KargJonas/minirack/system-design/components.ods

Sheet: Sheet1
Minirack hardware selection
Iteration 1
Component | Quantity | Price | Total Price | Status | Notes
Banana Pi BPI-R3 Wi-Fi 6 Router | 1.00 | €151.00 | €151.00
CWWK Mainboard i5-8265U | 1.00 | €201.00 | €201.00
GeeekPi DeskPi RackMate T1, 8U | 1.00 | €141.17 | €141.17
MEAN WELL NPB-120-24TB Battery charger | 1.00 | €54.68 | €54.68
Landport Batteries LP T12 Bleiakku, 12 V / 26 Ah | 2.00 | €77.89 | €155.78
Victron Orion-Tr 24/12-20 DC-DC Converter | 1.00 | €50.49 | €50.49
PicoPSU Power Supply | €1.00 | €30.00 | €30.00
 |  |  | Total
 |  |  | €784.12
Iteration 2
Component | Quantity | Price | Total Price
Banana Pi BPI-R3 Wi-Fi 6 Router | 1.00 | €151.00 | €151.00
CWWK Mainboard i5-8265U | 1.00 | €201.00 | €201.00
GeeekPi DeskPi RackMate T1, 8U | 1.00 | €141.17 | €141.17
MEAN WELL NPB-120-24TB Battery charger | 1.00 | €54.68 | €54.68
Eve LF50K - LiFePO4 3.2V 50Ah - Grade A Battery | 8.00 | €16.99 | €135.92 |  | Switched from lead acid to LiFePO4
JKBMS JK-B1A8S10P Battery management sytem | 1.00 | 40.43 € | 40.43 €
Victron Orion-Tr 24/12-20 DC-DC Converter | 1.00 | €50.49 | €50.49
PicoPSU Power Supply | 1.00 | €30.00 | €30.00
 |  |  | Total
 |  |  | €804.69
Iteration 3
Component | Quantity | Price | Total Price
Cudy AX3000 v1.0 WiFi 6 Router with 2.5G LAN + 4x1G LAN | 1.00 | €49.30 | €49.30 |  | 3x cheaper router with effectively the same specs + included antennas
CWWK Mainboard i5-8265U | 1.00 | €201.00 | €201.00
GeeekPi DeskPi RackMate T1, 8U | 1.00 | €141.17 | €141.17
MEAN WELL NPB-120-24TB Battery charger | 1.00 | €54.68 | €54.68
Eve LF50K - LiFePO4 3.2V 50Ah - Grade A Battery | 8.00 | €16.99 | €135.92
JKBMS JK-B1A8S10P Battery management sytem | 1.00 | 40.43 € | 40.43 €
Victron Orion-Tr 24/12-20 DC-DC Converter | 1.00 | €50.49 | €50.49
PicoPSU Power Supply | 1.00 | €30.00 | €30.00
 |  |  | Total
 |  |  | €702.99
Iteration 4
Component | Quantity | Price | Total Price
Cudy AX3000 v1.0 WiFi 6 Router with 2.5G LAN + 4x1G LAN | 1.00 | €49.30 | €49.30
CWWK Mainboard i5-8265U | 1.00 | €201.00 | €201.00
GeeekPi DeskPi RackMate T1, 8U | 1.00 | €141.17 | €141.17
MEAN WELL NPB-360-24TB Battery charger | 1.00 | €97.67 | €97.67 |  | Upgraded battery charger from 120W to 360W for more headroom.
Eve LF50K - LiFePO4 3.2V 50Ah - Grade A Battery | 8.00 | €16.99 | €135.92
JKBMS JK-B1A8S10P Battery management sytem | 1.00 | 40.43 € | 40.43 €
Victron Orion-Tr 24/12-20 DC-DC Converter | 1.00 | €50.49 | €50.49
PicoPSU Power Supply | 1.00 | €30.00 | €30.00
 |  |  | Total
 |  |  | €745.98
Iteration 5
Component | Quantity | Price | Total Price
Cudy AX3000 v1.0 WiFi 6 Router with 2.5G LAN + 4x1G LAN | 1.00 | €49.30 | €49.30 | Received
CWWK Mainboard i5-8265U | 1.00 | €201.00 | €201.00 | Received
GeeekPi DeskPi RackMate T1, 8U | 1.00 | €141.17 | €141.17 | Received
MEAN WELL NPB-360-24TB Battery charger | 1.00 | €97.67 | €97.67 | Ordered | Li profile holds 28.8V (3.6V/cell) continuously Consider programmable variant (SBP-001) set to ~27.6V to reduce cell aging..
Eve LF50K - LiFePO4 3.2V 50Ah - Grade A Battery | 8.00 | €16.99 | €135.92 | Ordered
JKBMS JK-B1A8S10P Battery management sytem | 1.00 | €40.43 | €40.43 | Ordered
Victron Orion-Tr 24/12-20 DC-DC Converter | 1.00 | €50.49 | €50.49 | Received
PicoPSU Power Supply | 1.00 | €30.00 | €30.00 | Received
Distribution & protection: MIDI fuse + holder, blade-fuse block, bus bar, 2.5mm2 wire, lugs, crimper | 1.00 | €75.00 | €75.00 |  | Estimate.
Cell compression fixture + pack hardware | 1.00 | €20.00 | €20.00 |  | Estimate. Busbars usually ship with cells; top-balance before first assembly.
Monitoring: MCU + RTC, INA3221/INA226, battery shunt, temp/humidity sensors | 1.00 | €40.00 | €40.00 | Ordered | Estimate.
 |  |  | Total
 |  |  | €880.98

Sheet: Sheet2
Rack manager hardware selection
Iteration 1
Component | Quantity | Price | Total Price | Status | Notes
WT32-ETH01 Microcontroller Board | 1.00 | 6.06 € | 6.06 € |  | Rationale: Since the ESP32 is built for networking, we can connect it directly to the Switch, which means it stays accessible even if the other components go Down, which is what we need from a rack manager. Aside from that, this board is cheap, already has an RJ45 connector, Has good arduino support, does not require an OS, which improves Reliability, has plenty of digital and analog IO and allows programming Over ethernet with the right firmware. Perfect fit overall
TCA9548A I2C Multiplexer | 1.00 | 0.39 € | 0.39 €
AHT20 + BMP280 Temperature, Pressure, Humidity Sensor Board | 6.00 | 0.94 € | 5.64 €
QNPT03 2mA/2mA Potential Transformer | 5.00 | 0.48 € | 2.40 € |  | Bought 4 more than needed for future projects
QNCT16L 2000-1 50A Current Transformer | 5.00 | 0.71 € | 3.55 € |  | Bought 4 more than needed for future projects
ADS131M02IRUKR | 2.00 | 1.45 € | 2.90 € |  | For voltage/current measurement at AC input and at the 12V rail
