KargJonas/minirack/cad/layout/layout.FCStd

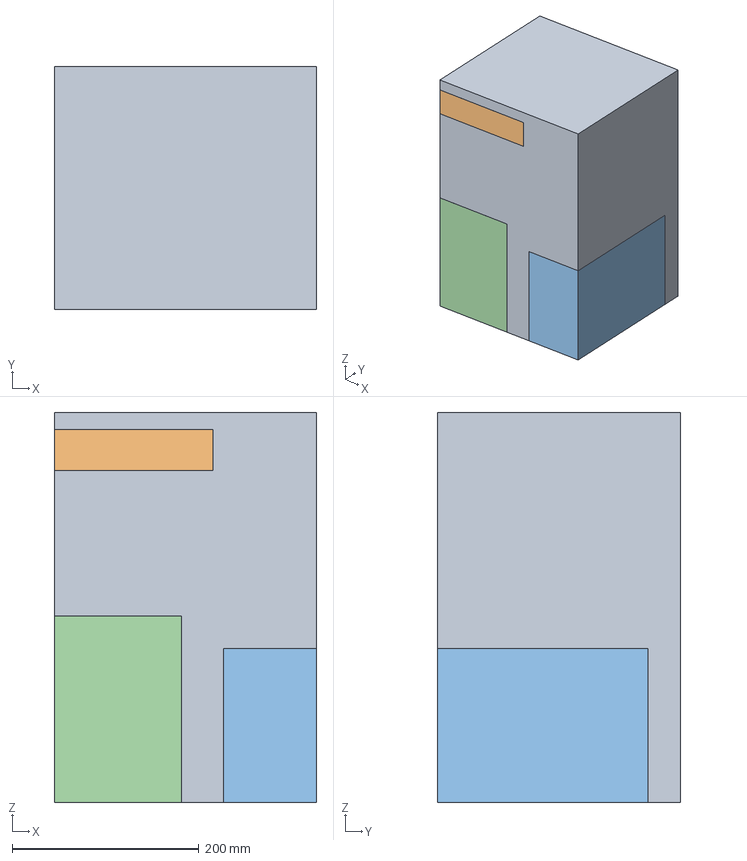
[picture p1: CAD file, 2026-07-11]
cad/layout/layout.FCStd
281.0 x 260.0 x 418.0 mm
Usable Volume
Mainboard
NAS
Battery
