KargJonas/minirack/cad/mini-itx-dimensions/Mini-ITX.STEP

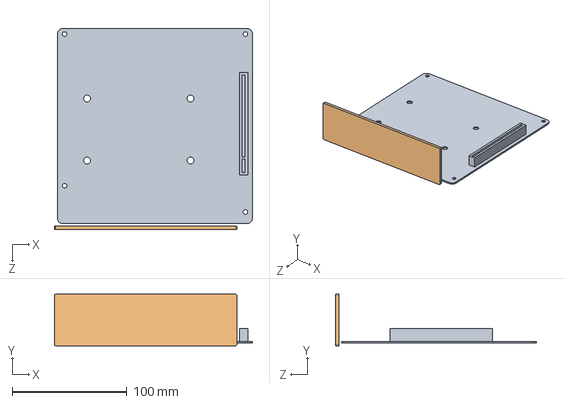
[picture p2: CAD file, 2026-07-11]
cad/mini-itx-dimensions/Mini-ITX.STEP
172.4 x 44.9 x 175.1 mm
