KargJonas/minirack/cad/shelves/3d-printing-files/packed-parts.3mf

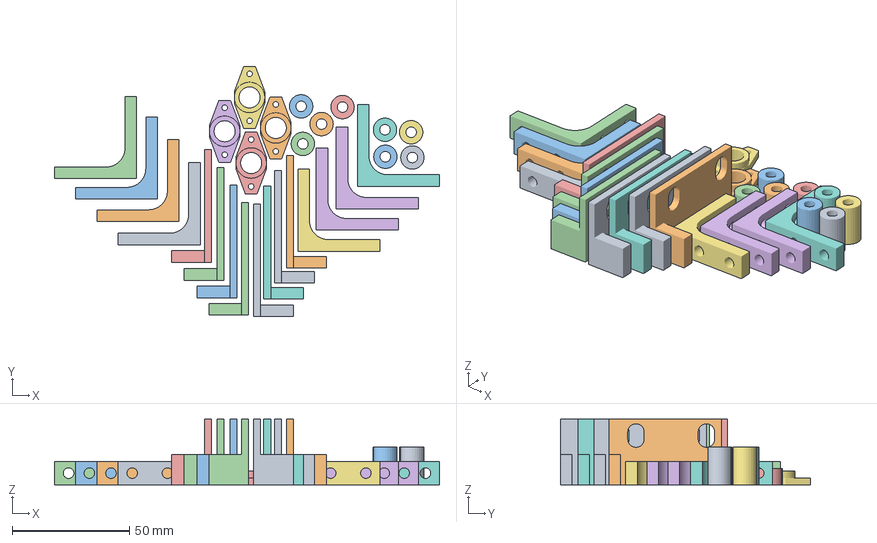
[picture p3: CAD file, 2026-07-16]
cad/shelves/3d-printing-files/packed-parts.3mf
163.9 x 106.5 x 28.0 mm
rear-mount-left.3mf
antenna-holder.3mf
router-spacer.3mf
rear-mount-right.3mf
mini-itx-spacer.3mf
gusset.3mf
router-spacer.3mf(1)
router-spacer.3mf(2)
router-spacer.3mf(3)
mini-itx-spacer.3mf(1)
mini-itx-spacer.3mf(2)
mini-itx-spacer.3mf(3)
antenna-holder.3mf(1)
antenna-holder.3mf(2)
antenna-holder.3mf(3)
rear-mount-left.3mf(1)
rear-mount-left.3mf(2)
rear-mount-left.3mf(3)
rear-mount-right.3mf(1)
rear-mount-right.3mf(2)
rear-mount-right.3mf(3)
gusset.3mf(1)
gusset.3mf(2)
gusset.3mf(3)
gusset.3mf(4)
gusset.3mf(5)
gusset.3mf(6)
gusset.3mf(7)
