KargJonas/minirack/cad/shelves/antenna-holder-flat.FCStd

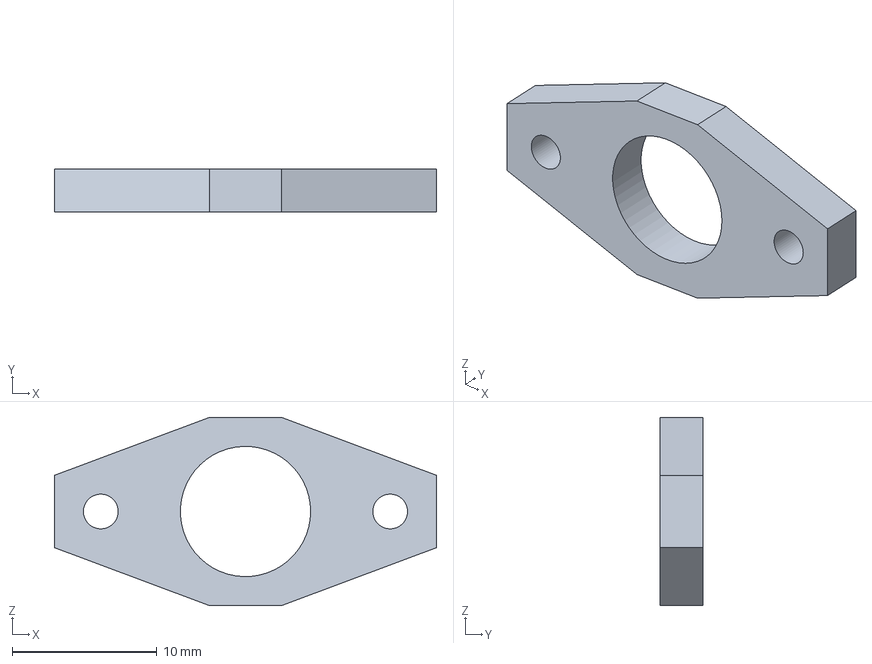
[picture p4: CAD file, 2026-10-18]
cad/shelves/antenna-holder-flat.FCStd
26.4 x 3.00 x 13.0 mm
