KargJonas/minirack/cad/shelves/cnc-files/rack-bottom-plate-Body.step

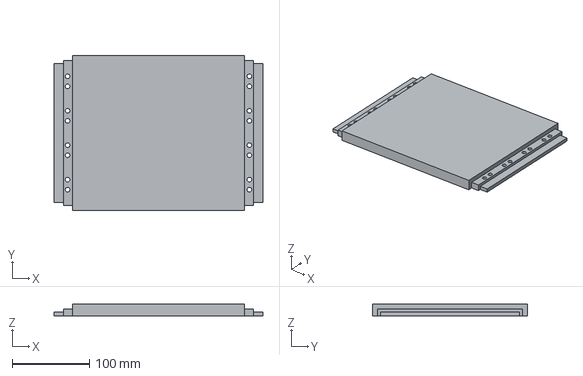
[picture p5: CAD file, 2026-07-21]
cad/shelves/cnc-files/rack-bottom-plate-Body.step
270.0 x 200.0 x 15.0 mm
