KargJonas/minirack/rack-manager/eda/symbols/ADS131M02IRUKR/RUK0020B.stp

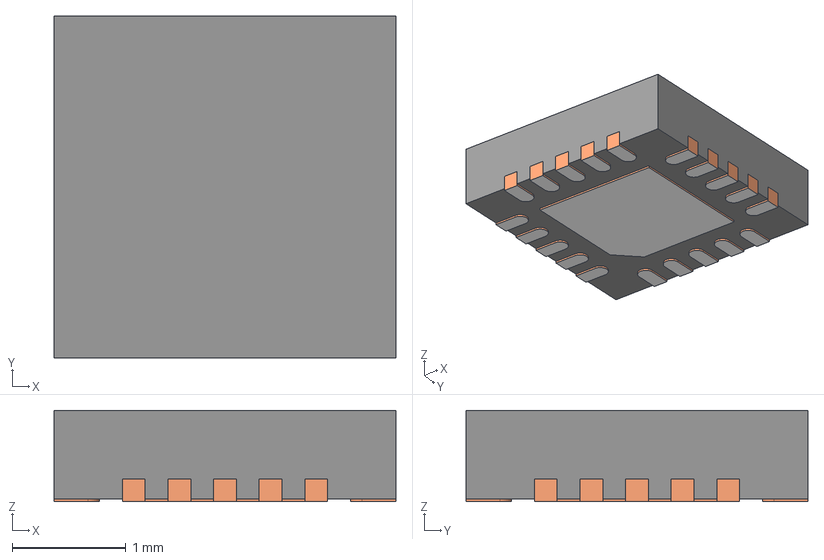
[picture p6: CAD file, 2026-07-13]
rack-manager/eda/symbols/ADS131M02IRUKR/RUK0020B.stp
3.00 x 3.00 x 0.8 mm
BODY-QFN
FRAME-RUK0020B
PIN1-ID
