KargJonas/minirack/cad/misc/power-rail-box-bottom-Body.3mf

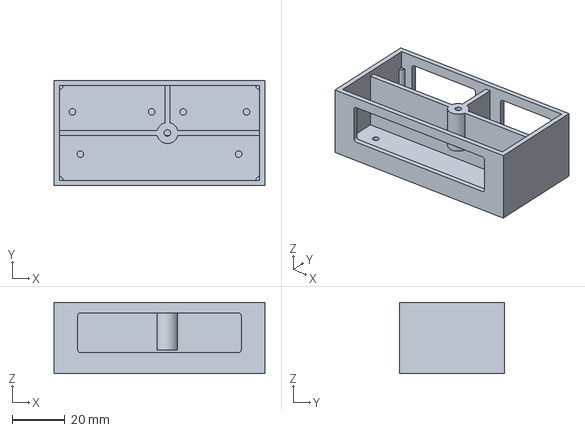
[picture p7: CAD file, 2026-10-18]
cad/misc/power-rail-box-bottom-Body.3mf
80.0 x 40.0 x 27.0 mm
