KargJonas/minirack/cad/shelves/cnc-files/router-shelf-bottom-plate-with-ventillation.dxf

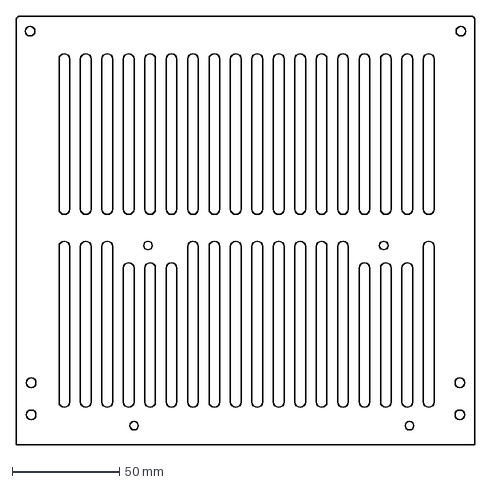
[picture p8: CAD file, 2026-07-18]
cad/shelves/cnc-files/router-shelf-bottom-plate-with-ventillation.dxf
214.0 x 200.0 mm
