KargJonas/minirack/cad/misc/power-rail-box.FCStd

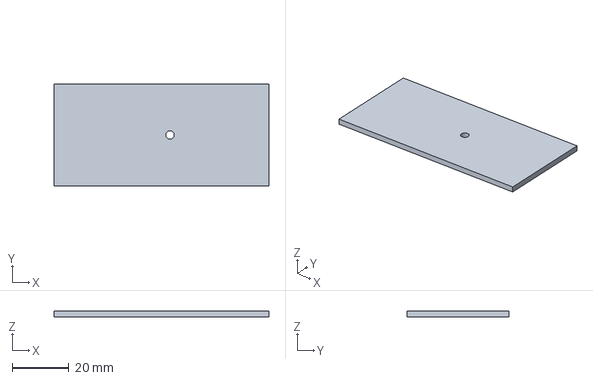
[picture p9: CAD file, 2026-10-18]
cad/misc/power-rail-box.FCStd
76.0 x 36.0 x 2.00 mm
