KargJonas/minirack/cad/shelves/mini-itx-shelf.FCStd

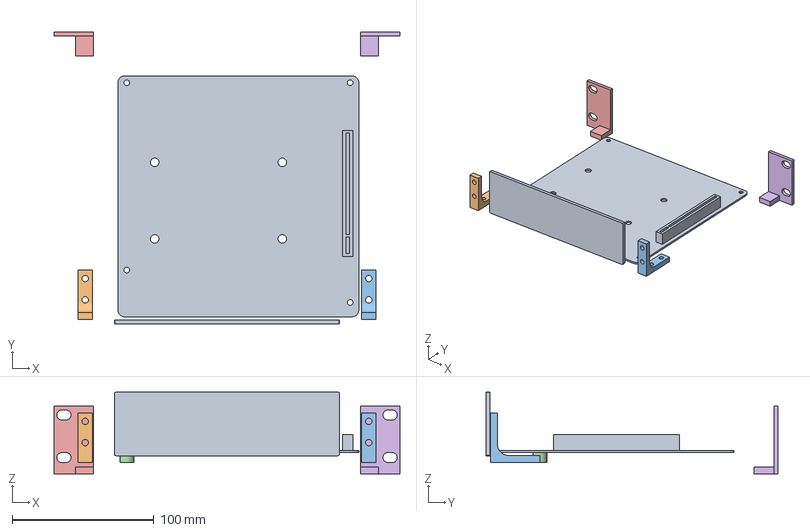
[picture p11: CAD file, 2026-09-18]
cad/shelves/mini-itx-shelf.FCStd
244.0 x 206.1 x 57.6 mm
Mini-ITX-Reference
gusset-reference-1
gusset-reference-2
mini-itx-spacer
rear-mount-left
rear-mount-right
