KargJonas/minirack/cad/misc/CE3E3V2_power-rail-box-Body.3mf

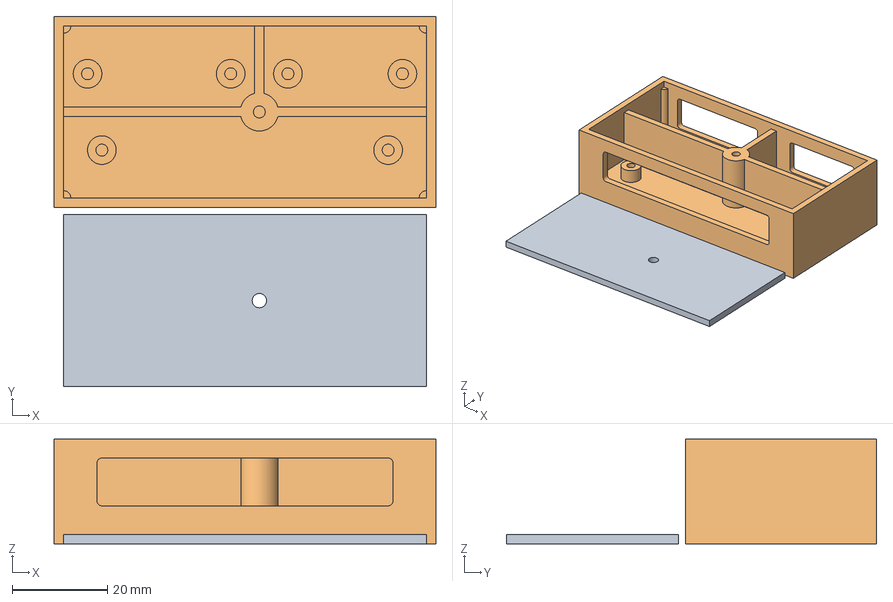
[picture p12: CAD file, 2026-10-18]
cad/misc/CE3E3V2_power-rail-box-Body.3mf
80.0 x 77.5 x 22.0 mm
power-rail-box-Body.3mf
power-rail-box-bottom-Body.3mf
