KargJonas/minirack/cad/shelves/router-shelf.FCStd

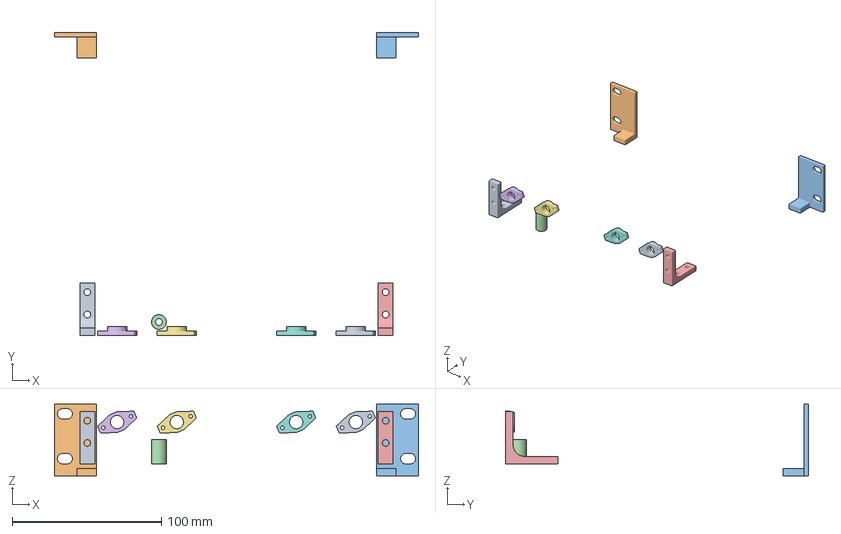
[picture p14: CAD file, 2026-09-18]
cad/shelves/router-shelf.FCStd
244.0 x 203.0 x 48.0 mm
gusset-reference-1
rear-mount-left
rear-mount-right
router-spacer
gusset-reference-2
antenna-holder-reference-1
antenna-holder-reference-2
antenna-holder-reference-3
antenna-holder-reference-4
