KargJonas/minirack/cad/shelves/antenna-holder.FCStd

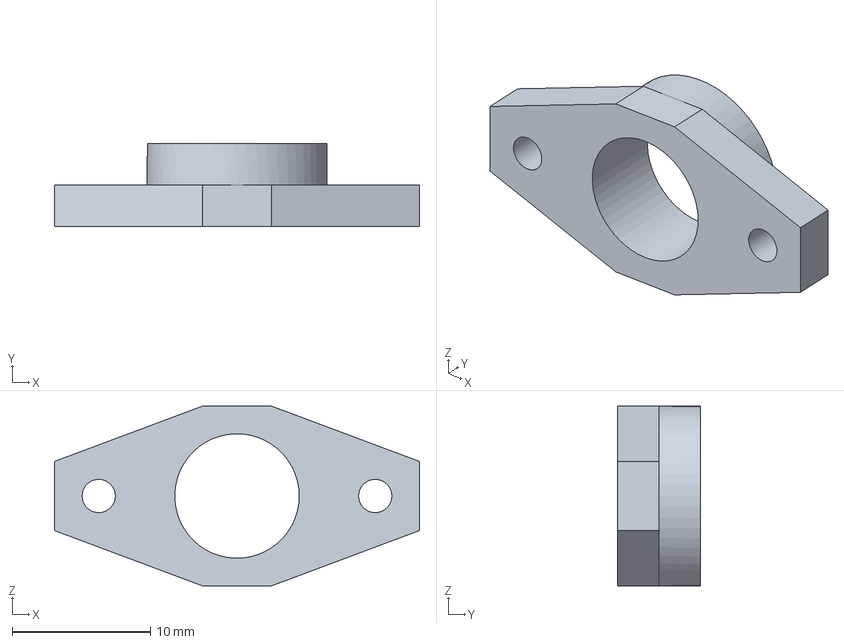
[picture p15: CAD file, 2026-07-15]
cad/shelves/antenna-holder.FCStd
26.4 x 6.00 x 13.0 mm
