KargJonas/minirack/cad/shelves/cnc-files/2u-shelf-front-plate.dxf

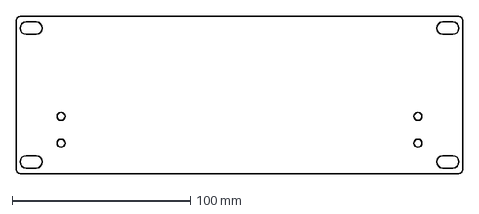
[picture p17: CAD file, 2026-07-15]
cad/shelves/cnc-files/2u-shelf-front-plate.dxf
250.0 x 88.0 mm
