KargJonas/minirack/cad/shelves/rear-mount-left.FCStd

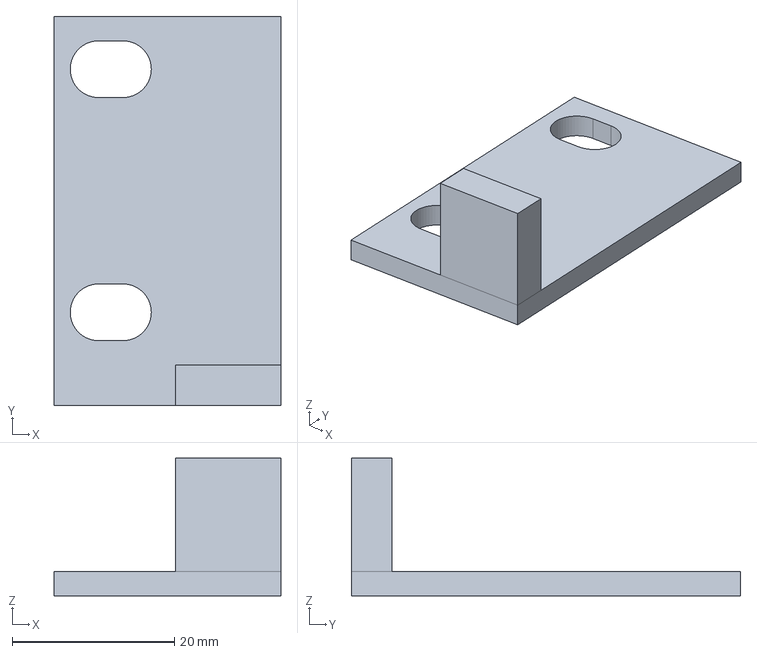
[picture p18: CAD file, 2026-07-15]
cad/shelves/rear-mount-left.FCStd
28.0 x 48.0 x 17.0 mm
