KargJonas/minirack/cad/shelves/cnc-files/mini-itx-shelf-front-plate.dxf

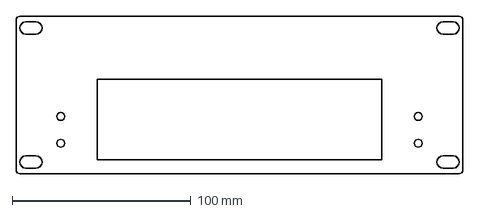
[picture p19: CAD file, 2026-07-15]
cad/shelves/cnc-files/mini-itx-shelf-front-plate.dxf
250.0 x 88.0 mm
