KargJonas/minirack/cad/shelves/cnc-files/1u-shelf-front-plate.dxf

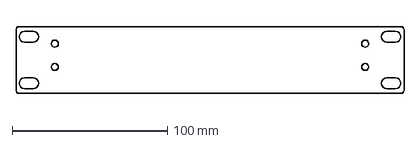
[picture p20: CAD file, 2026-07-15]
cad/shelves/cnc-files/1u-shelf-front-plate.dxf
250.0 x 43.0 mm
