KargJonas/minirack/cad/shelves/router-spacer.3mf

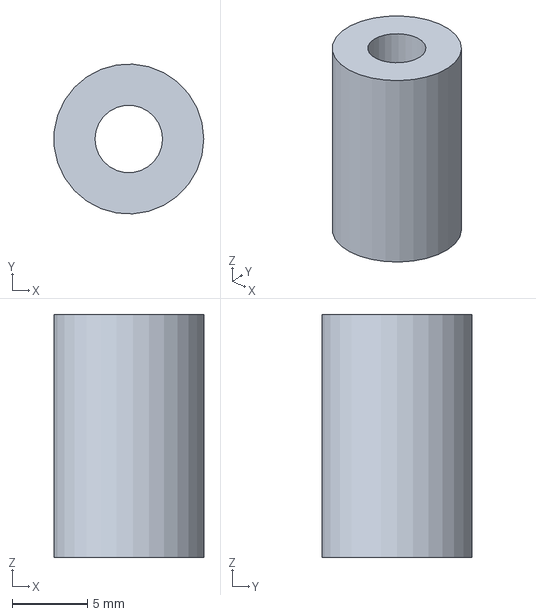
[picture p21: CAD file, 2026-07-15]
cad/shelves/router-spacer.3mf
9.97 x 9.99 x 16.2 mm
