KargJonas/minirack/cad/shelves/cnc-files/router-shelf-front-plate.dxf

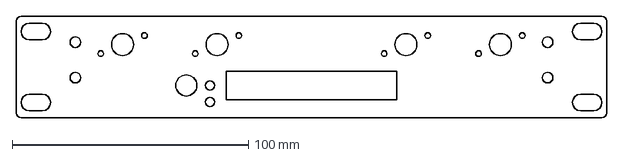
[picture p22: CAD file, 2026-07-15]
cad/shelves/cnc-files/router-shelf-front-plate.dxf
250.0 x 43.0 mm
