KargJonas/minirack/cad/shelves/cnc-files/mini-itx-shelf-bottom-plate.dxf

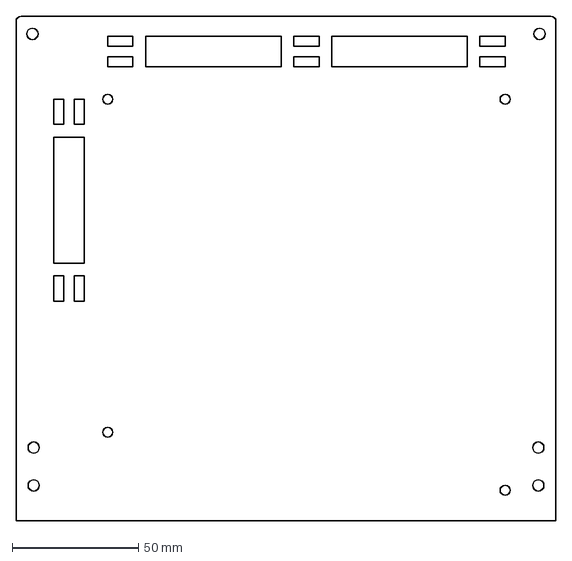
[picture p23: CAD file, 2026-07-15]
cad/shelves/cnc-files/mini-itx-shelf-bottom-plate.dxf
214.0 x 200.0 mm
