KargJonas/minirack/cad/shelves/gusset.FCStd

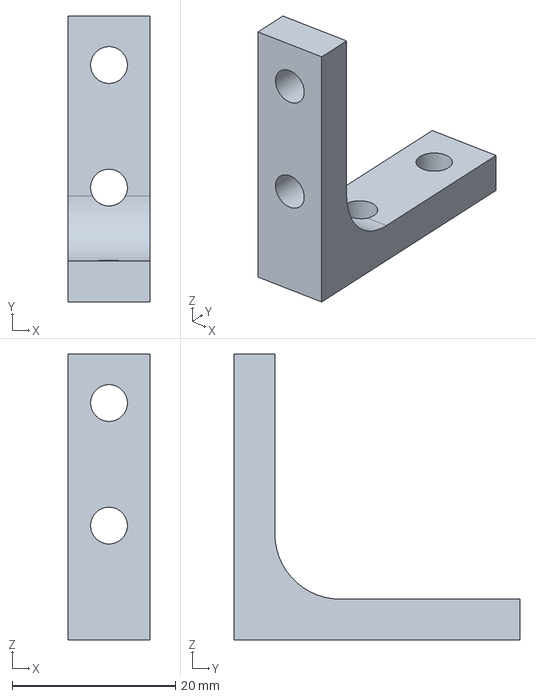
[picture p24: CAD file, 2026-07-15]
cad/shelves/gusset.FCStd
10.0 x 35.0 x 35.0 mm
