KargJonas/minirack/cad/shelves/mini-itx-spacer.3mf

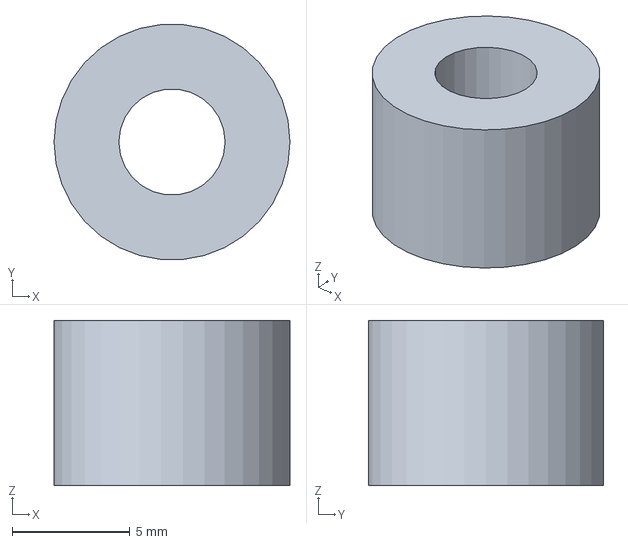
[picture p25: CAD file, 2026-07-15]
cad/shelves/mini-itx-spacer.3mf
10.0 x 9.96 x 7.00 mm
