KargJonas/minirack/cad/shelves/itxflex_2u.fcstd

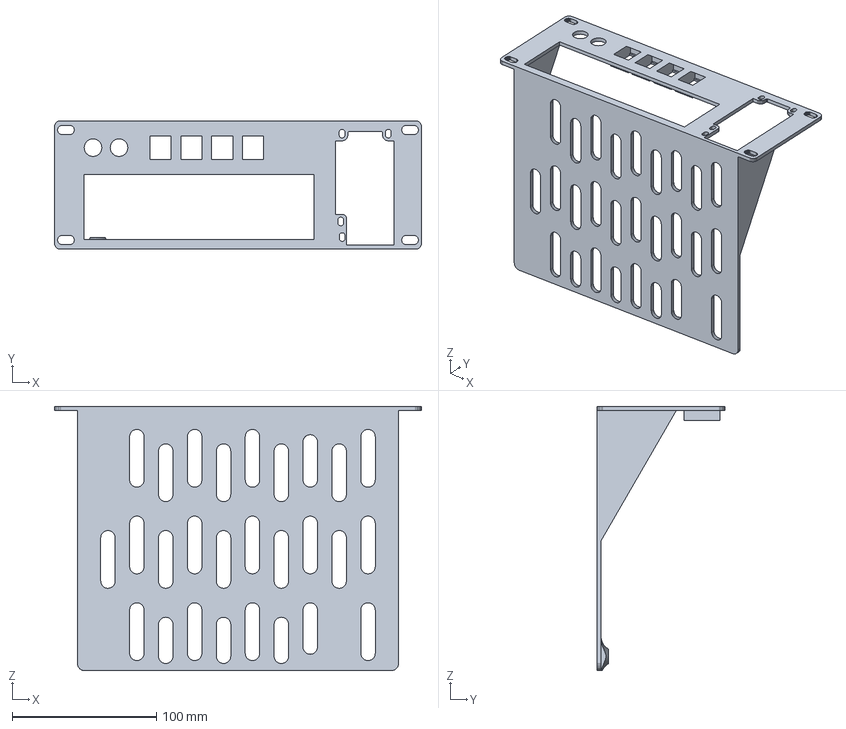
[picture p26: CAD file, 2026-07-11]
cad/shelves/itxflex_2u.fcstd
254.0 x 88.9 x 183.0 mm
