KargJonas/minirack/(list of files, cad)

Other CAD files:
cad/misc/test.FCStd
cad/shelves/rack-bottom-plate.FCStd
cad/misc/power-rail-box-bottom.FCStd
cad/misc/power-rail-box-Body.3mf
cad/shelves/1u-shelf.FCStd
cad/shelves/rear-mount-right.FCStd
cad/shelves/2u-shelf.FCStd
cad/shelves/router-spacers.FCStd
cad/shelves/mini-itx-spacers.FCStd
cad/shelves/antenna-holder-flat.3mf
cad/shelves/antenna-holder.3mf
cad/shelves/gusset.3mf
cad/shelves/rear-mount-left.3mf
cad/shelves/rear-mount-right.3mf
