KargJonas/minirack/rack-manager/bringup/easy-ota/partitions_4mb.csv

# Shared partition table for all builds (4MB flash). Plain A/B:
# the serial flash puts the base image (EasyOTA only) into ota_0; every HTTP
# upload goes to the slot not currently running. A bad upload rolls back to
# the previous image; bad-but-validated images are handled by EasyOTA's
# crash-loop guard and reachability watchdog (see lib/EasyOTA).
# coredump holds the crash dump of the most recent panic, reported via
# /status for rollback diagnostics.
# Name,     Type, SubType,  Offset,   Size
nvs,        data, nvs,      0x9000,   0x5000,
otadata,    data, ota,      0xe000,   0x2000,
ota_0,      app,  ota_0,    0x10000,  0x1e0000,
ota_1,      app,  ota_1,    0x1f0000, 0x1e0000,
coredump,   data, coredump, 0x3d0000, 0x30000,
