KargJonas/minirack/cad/bottom-plate.pdf

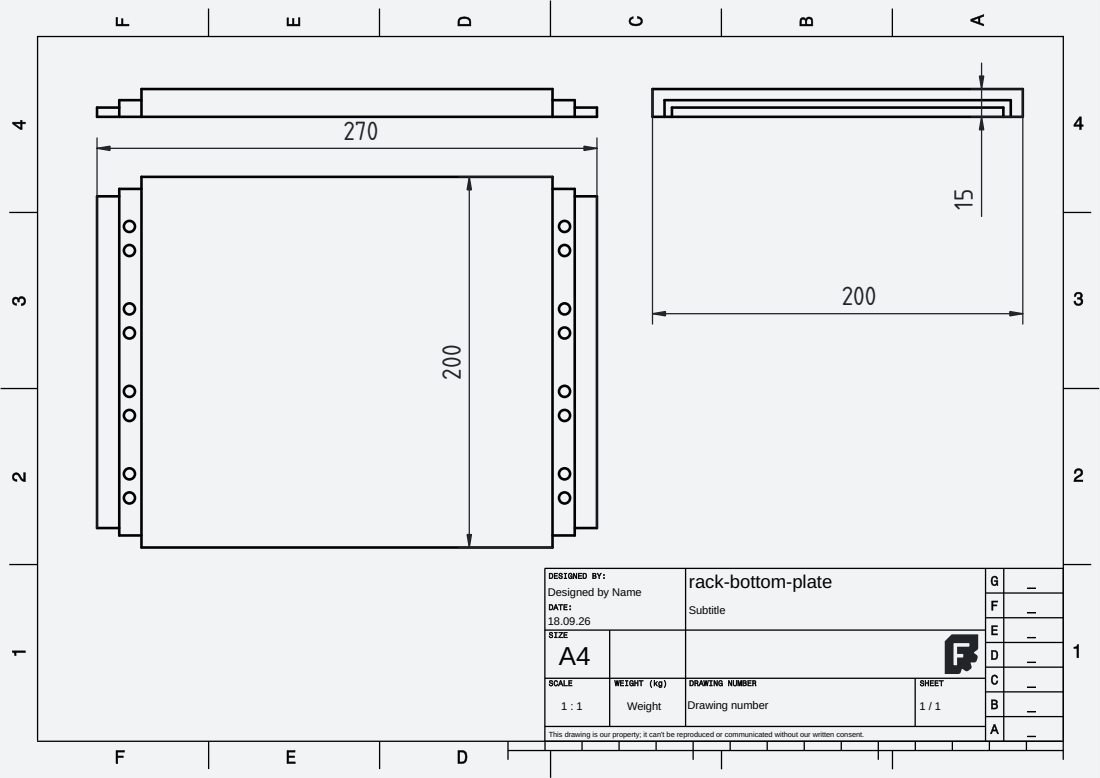
[picture p27: page 1]

Designed by Name 18.09.26 | rack-bottom-plate Subtitle

1 : 1 | Weight | Drawing number | 1 / 1

This drawing is our property; it can't be reproduced or communicated without our written consent.
