KargJonas/minirack/cad/router-plates-drawing.pdf

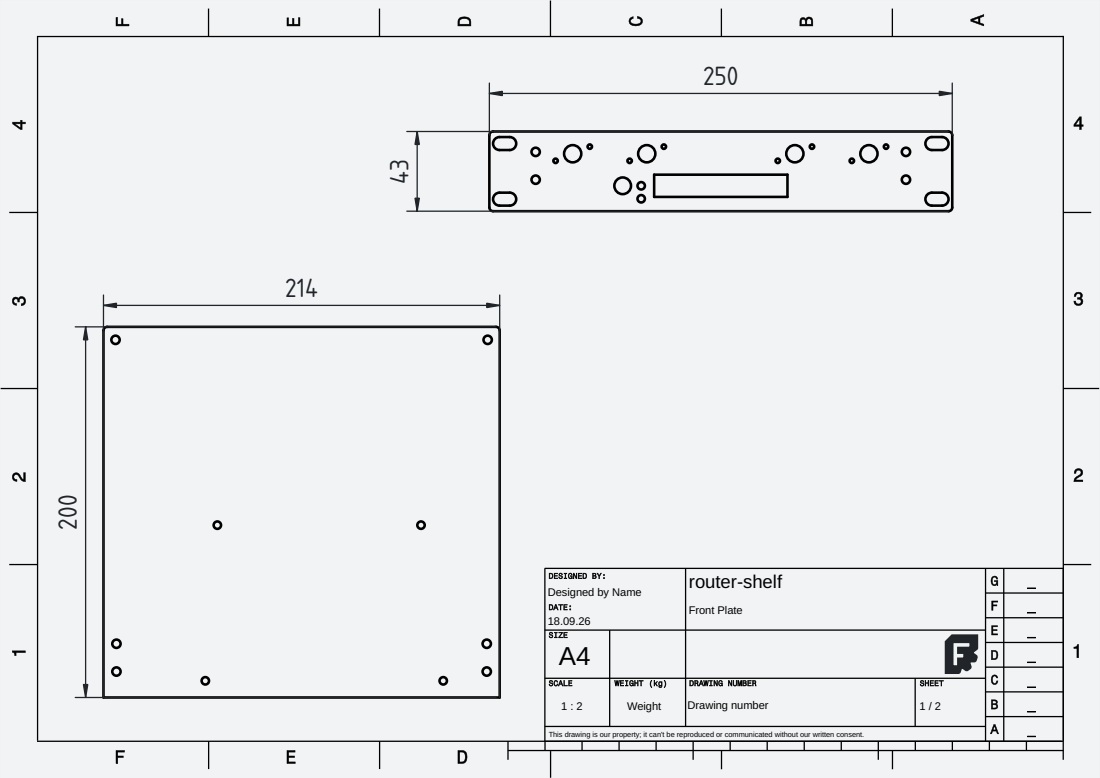
[picture p28: page 1]

Designed by Name 18.09.26 | router-shelf Front Plate

1 : 2 | Weight | Drawing number | 1 / 2

This drawing is our property; it can't be reproduced or communicated without our written consent.
