KargJonas/minirack/cad/mini-itx-plates-drawing.pdf

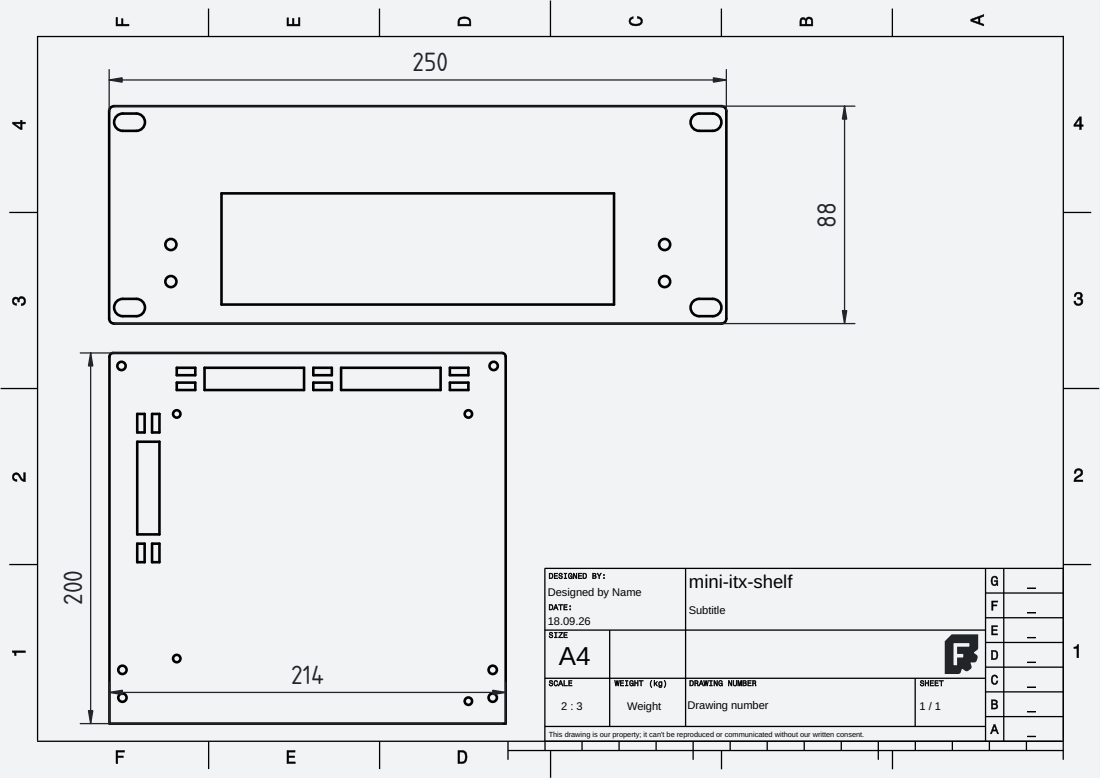
[picture p29: page 1]

Designed by Name 18.09.26 | mini-itx-shelf Subtitle

2 : 3 | Weight | Drawing number | 1 / 1

This drawing is our property; it can't be reproduced or communicated without our written consent.
