KargJonas/minirack/rack-manager/eda/rack-manager/rack-manager/rack-manager.kicad_pcb

## KiCad design rack-manager/eda/rack-manager/rack-manager/rack-manager.kicad_pcb (2026-07-15)

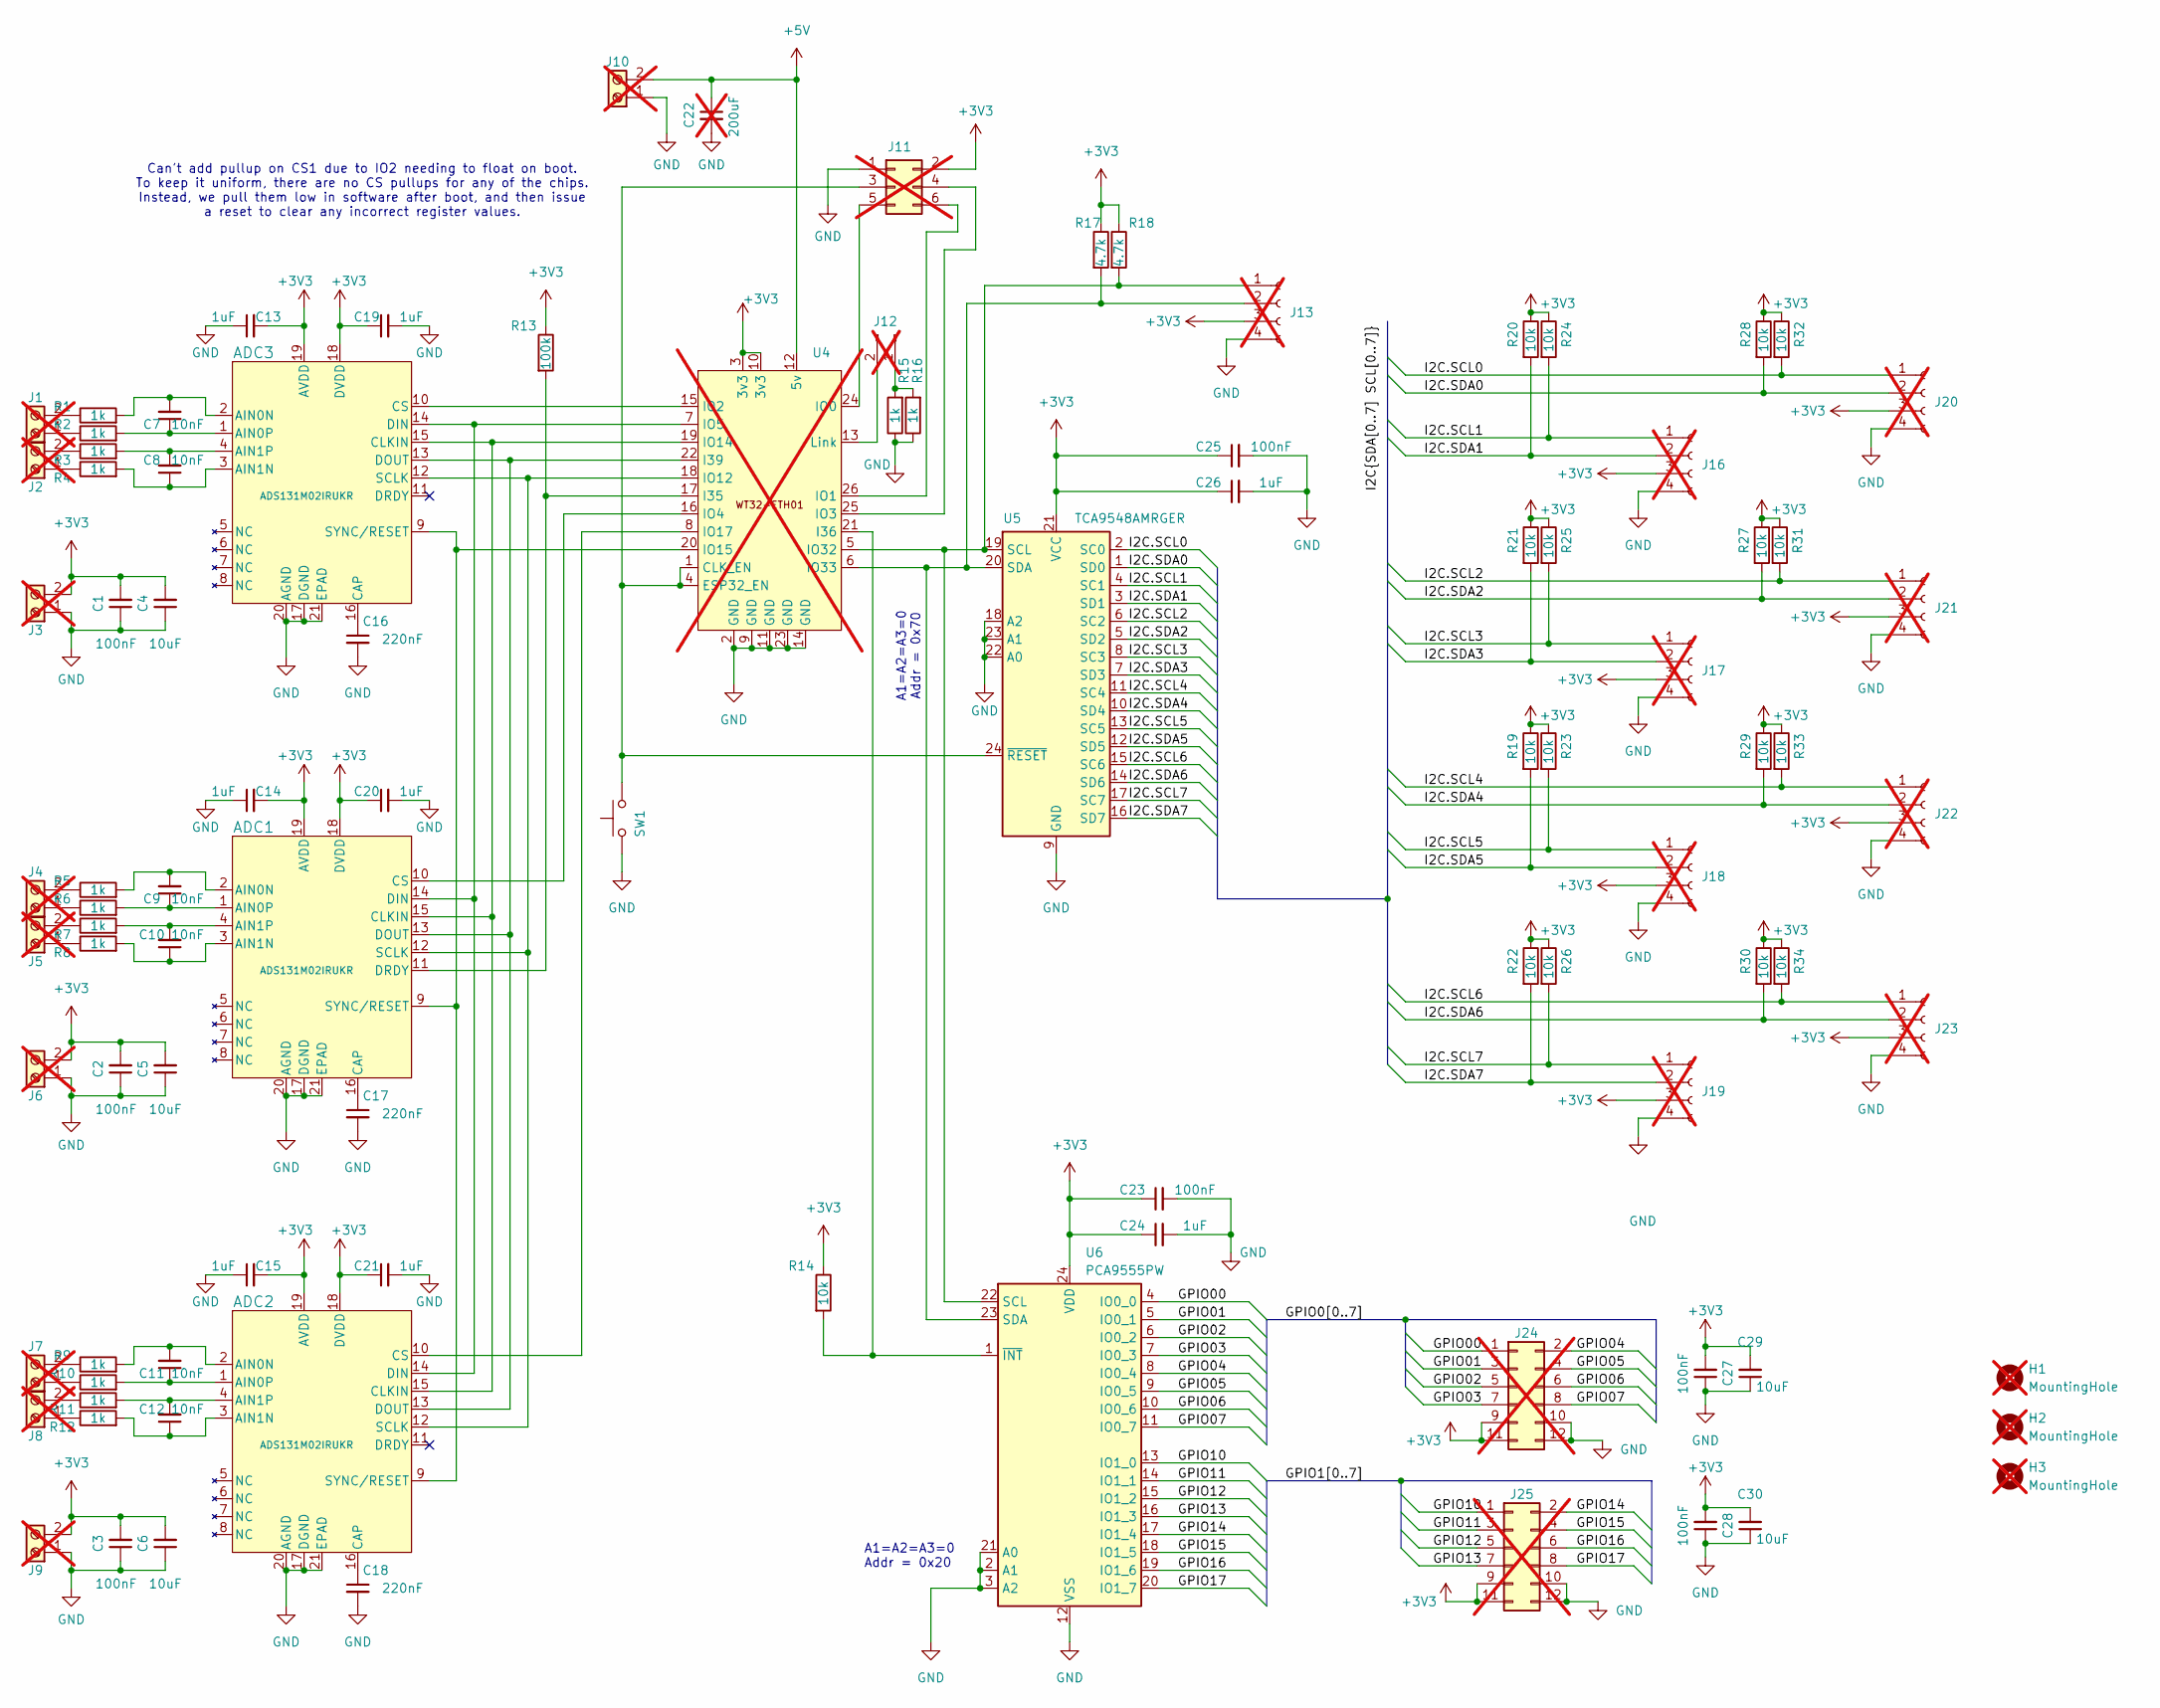
[picture p30: schematic rack-manager.kicad_sch]

Parts:
ADC1, ADC2, ADC3: ADS131M02IRUKR; WQFN-20-1EP_3x3mm_P0.4mm_EP1.7x1.7mm; LCSC C5215160
C1, C2, C3, C23, C25, C27, C28: 100nF; C_0603_1608Metric; LCSC C14663
C4, C5, C6, C29, C30: 10uF; C_0603_1608Metric; LCSC C19702
C7, C8, C9, C10, C11, C12: 10nF; C_0603_1608Metric; LCSC C57112
C13, C14, C15, C19, C20, C21, C24, C26: 1uF; C_0603_1608Metric; LCSC C15849
C16, C17, C18: 220nF; C_0603_1608Metric; LCSC C21120
C22: 200uF; CP_Radial_D8.0mm_P3.50mm; not fitted
H1, H2, H3: MountingHole; MountingHole_4.3mm_M4_ISO14580_Pad_TopBottom; not fitted
J1, J2, J3, J4, J5, J6, J7, J8, J9, J10: Screw_Terminal_01x02; TerminalBlock_Phoenix_MKDS-1-2-3.81_1x02_P3.81mm_Horizontal; not fitted
J11: Conn_02x03_Odd_Even; IDC-Header_2x03_P2.54mm_Vertical; not fitted
J12: Conn_01x02_Pin; PinHeader_1x02_P2.54mm_Vertical; not fitted
J13, J16, J17, J18, J19, J20, J21, J22, J23: Conn_01x04_Socket; JST_XH_B4B-XH-A_1x04_P2.50mm_Vertical; not fitted
J24, J25: Conn_02x06_Odd_Even; IDC-Header_2x06_P2.54mm_Vertical; not fitted
R1, R2, R3, R4, R5, R6, R7, R8, R9, R10, R11, R12, R15, R16: 1k; R_0603_1608Metric; LCSC C21190
R13: 100k; R_0603_1608Metric; LCSC C25803
R14, R19, R20, R21, R22, R23, R24, R25, R26, R27, R28, R29, R30, R31, R32, R33, R34: 10k; R_0603_1608Metric; LCSC C25804
R17, R18: 4.7k; R_0603_1608Metric; LCSC C23162
SW1: C720477; SW_Push_SPST_NO_Alps_SKRK; LCSC C720477
U4: WT32-ETH01; not fitted
U5: TCA9548AMRGER; Texas_RGE0024C_VQFN-24-1EP_4x4mm_P0.5mm_EP2.1x2.1mm
U6: PCA9555PW; TSSOP-24_4.4x7.8mm_P0.65mm

Connections:
+3V3: ADC1.18 (DVDD), ADC1.19 (AVDD), ADC2.18 (DVDD), ADC2.19 (AVDD), ADC3.18 (DVDD), ADC3.19 (AVDD), C1.2, C2.2, C3.2, C4.2, C5.2, C6.2, C13.2, C14.2, C15.2, C19.1, C20.1, C21.1, C23.1, C24.1, C25.1, C26.1, C27.2, C28.2, C29.2, C30.2, J3.2, J6.2, J9.2, J11.2, J13.3, J16.3, J17.3, J18.3, J19.3, J20.3, J21.3, J22.3, J23.3, J24.9, J24.11, J25.9, J25.11, R13.1, R14.1, R17.1, R18.1, R19.1, R20.1, R21.1, R22.1, R23.1, R24.1, R25.1, R26.1, R27.1, R28.1, R29.1, R30.1, R31.1, R32.1, R33.1, R34.1, U4.3 (3v3), U4.10 (3v3), U5.21 (VCC), U6.24 (VDD)
+5V: C22.1, J10.2, U4.12 (5v)
/GPIO00: J24.1, U6.4 (IO0_0)
/GPIO01: J24.3, U6.5 (IO0_1)
/GPIO02: J24.5, U6.6 (IO0_2)
/GPIO03: J24.7, U6.7 (IO0_3)
/GPIO04: J24.2, U6.8 (IO0_4)
/GPIO05: J24.4, U6.9 (IO0_5)
/GPIO06: J24.6, U6.10 (IO0_6)
/GPIO07: J24.8, U6.11 (IO0_7)
/GPIO10: J25.1, U6.13 (IO1_0)
/GPIO11: J25.3, U6.14 (IO1_1)
/GPIO12: J25.5, U6.15 (IO1_2)
/GPIO13: J25.7, U6.16 (IO1_3)
/GPIO14: J25.2, U6.17 (IO1_4)
/GPIO15: J25.4, U6.18 (IO1_5)
/GPIO16: J25.6, U6.19 (IO1_6)
/GPIO17: J25.8, U6.20 (IO1_7)
/I2C.SCL0: J20.1, R32.2, U5.2 (SC0)
/I2C.SCL1: J16.1, R24.2, U5.4 (SC1)
/I2C.SCL2: J21.1, R31.2, U5.6 (SC2)
/I2C.SCL3: J17.1, R25.2, U5.8 (SC3)
/I2C.SCL4: J22.1, R33.2, U5.11 (SC4)
/I2C.SCL5: J18.1, R23.2, U5.13 (SC5)
/I2C.SCL6: J23.1, R34.2, U5.15 (SC6)
/I2C.SCL7: J19.1, R26.2, U5.17 (SC7)
/I2C.SDA0: J20.2, R28.2, U5.1 (SD0)
/I2C.SDA1: J16.2, R20.2, U5.3 (SD1)
/I2C.SDA2: J21.2, R27.2, U5.5 (SD2)
/I2C.SDA3: J17.2, R21.2, U5.7 (SD3)
/I2C.SDA4: J22.2, R29.2, U5.10 (SD4)
/I2C.SDA5: J18.2, R19.2, U5.12 (SD5)
/I2C.SDA6: J23.2, R30.2, U5.14 (SD6)
/I2C.SDA7: J19.2, R22.2, U5.16 (SD7)
GND: ADC1.17 (DGND), ADC1.20 (AGND), ADC1.21 (EPAD), ADC2.17 (DGND), ADC2.20 (AGND), ADC2.21 (EPAD), ADC3.17 (DGND), ADC3.20 (AGND), ADC3.21 (EPAD), C1.1, C2.1, C3.1, C4.1, C5.1, C6.1, C13.1, C14.1, C15.1, C16.2, C17.2, C18.2, C19.2, C20.2, C21.2, C22.2, C23.2, C24.2, C25.2, C26.2, C27.1, C28.1, C29.1, C30.1, J3.1, J6.1, J9.1, J10.1, J11.1, J13.4, J16.4, J17.4, J18.4, J19.4, J20.4, J21.4, J22.4, J23.4, J24.10, J24.12, J25.10, J25.12, R15.1, R16.1, SW1.1, U4.2 (GND), U4.9 (GND), U4.11 (GND), U4.14 (GND), U4.23 (GND), U5.9 (GND), U5.18 (A2), U5.22 (A0), U5.23 (A1), U6.2 (A1), U6.3 (A2), U6.12 (VSS), U6.21 (A0)
unnamed: ADC1.2 (AIN0N), C9.2, R5.2
unnamed: ADC1.1 (AIN0P), C9.1, R6.2
unnamed: ADC1.3 (AIN1N), C10.1, R8.2
unnamed: ADC1.4 (AIN1P), C10.2, R7.2
unnamed: ADC1.16 (CAP), C17.1
unnamed: ADC1.15 (CLKIN), ADC2.15 (CLKIN), ADC3.15 (CLKIN), U4.19 (IO14)
unnamed: ADC1.10 (CS), U4.16 (IO4)
unnamed: ADC1.14 (DIN), ADC2.14 (DIN), ADC3.14 (DIN), U4.7 (IO5)
unnamed: ADC1.13 (DOUT), ADC2.13 (DOUT), ADC3.13 (DOUT), U4.22 (I39)
unnamed: ADC1.11 (DRDY), R13.2, U4.17 (I35)
unnamed: ADC1.12 (SCLK), ADC2.12 (SCLK), ADC3.12 (SCLK), U4.18 (IO12)
unnamed: ADC1.9 (SYNC/RESET), ADC2.9 (SYNC/RESET), ADC3.9 (SYNC/RESET), U4.20 (IO15)
unnamed: ADC2.2 (AIN0N), C11.2, R9.2
unnamed: ADC2.1 (AIN0P), C11.1, R10.2
unnamed: ADC2.3 (AIN1N), C12.1, R12.2
unnamed: ADC2.4 (AIN1P), C12.2, R11.2
unnamed: ADC2.16 (CAP), C18.1
unnamed: ADC2.10 (CS), U4.8 (IO17)
unnamed: ADC3.2 (AIN0N), C7.2, R1.2
unnamed: ADC3.1 (AIN0P), C7.1, R2.2
unnamed: ADC3.3 (AIN1N), C8.1, R4.2
unnamed: ADC3.4 (AIN1P), C8.2, R3.2
unnamed: ADC3.16 (CAP), C16.1
unnamed: ADC3.10 (CS), U4.15 (IO2)
unnamed: J1.1, R2.1
unnamed: J1.2, R1.1
unnamed: J2.1, R4.1
unnamed: J2.2, R3.1
unnamed: J4.1, R6.1
unnamed: J4.2, R5.1
unnamed: J5.1, R8.1
unnamed: J5.2, R7.1
unnamed: J7.1, R10.1
unnamed: J7.2, R9.1
unnamed: J8.1, R12.1
unnamed: J8.2, R11.1
unnamed: J11.3, SW1.2, U4.1 (CLK_EN), U4.4 (ESP32_EN), U5.24 (~RESET)
unnamed: J11.4, U4.25 (IO3)
unnamed: J11.5, U4.24 (IO0)
unnamed: J11.6, U4.26 (IO1)
unnamed: J12.1, R15.2, R16.2
unnamed: J12.2, U4.13 (Link)
unnamed: J13.1, R18.2, U4.5 (IO32), U5.19 (SCL), U6.22 (SCL)
unnamed: J13.2, R17.2, U4.6 (IO33), U5.20 (SDA), U6.23 (SDA)
unnamed: R14.2, U4.21 (I36), U6.1 (~INT)

Notes on the sheet:
Can't add pullup on CS1 due to IO2 needing to float on boot. To keep it uniform, there are no CS pullups for any of the chips. Instead, we pull them low in software after boot, and then issue a reset to clear any incorrect register values.
A1=A2=A3=0 Addr = 0x20
A1=A2=A3=0 Addr = 0x70

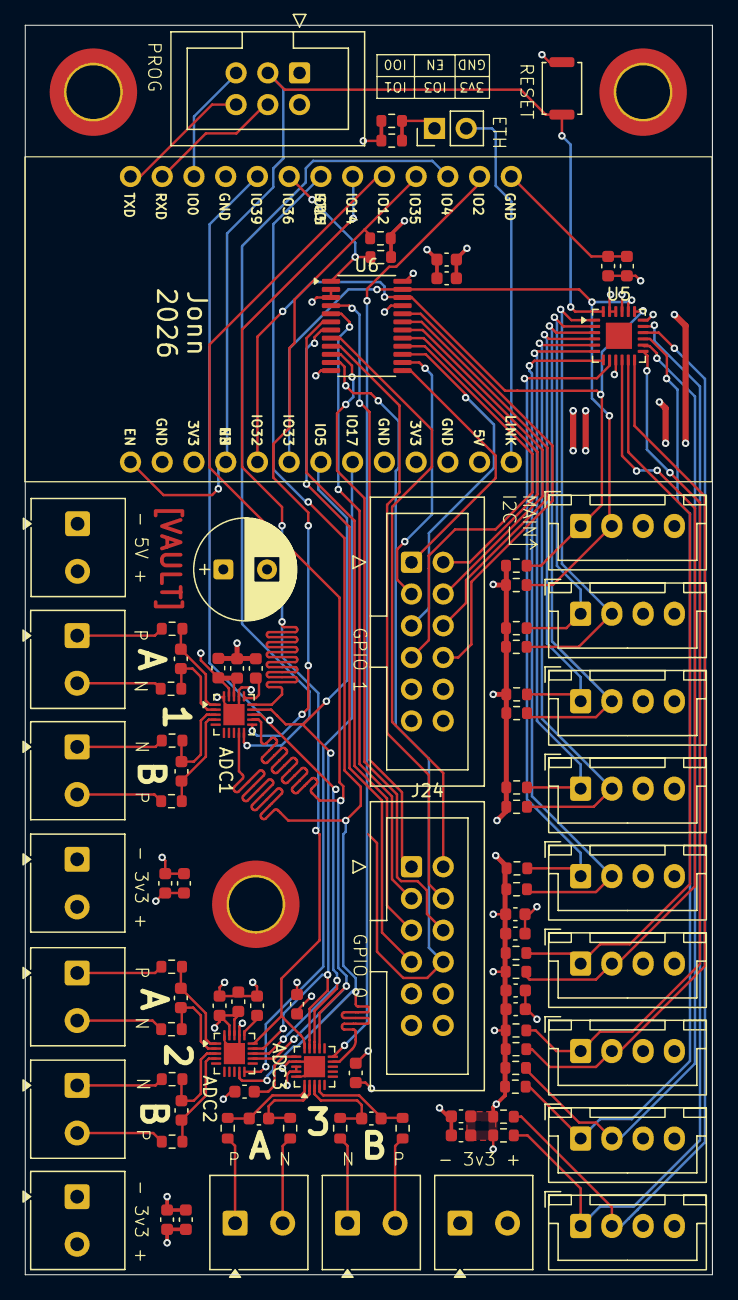
[picture p31: board rack-manager.kicad_pcb from above]

Board: 4 copper layers, 55.0 x 100.0 mm, 97 parts (0 on the bottom side), 80 nets.
