KargJonas/minirack/(commit log)

2026-07-08 Component selection work, rough CAD design for component layout
    [components.ods, layout.FCStd]
2026-07-09 Rack manager schematic work
    [rack-manager.kicad_pcb, rack-manager.kicad_sch]
2026-07-10 Fixed some schematic issues, added gpio expander
    [components.ods, layout.FCStd, rack-manager.kicad_sch]
2026-07-11 CAD model for mini ITX mainboard
    [2u-shelf.FCStd, Mini-ITX.STEP, SC1_Z97I-PLUS.SLDPRT, SC1_Z97I-PLUS.STEP, analog-front-end.kicad_sch, components.ods, itxflex_2u.fcstd, layout.FCStd]
2026-07-11 CAD models for ITX Shelf, Router shelf, Spacers, Rear mount
    [1u-shelf.FCStd, 2u-shelf.FCStd, mini-itx-shelf-Mini ITX Shelf.3mf, mini-itx-shelf-Minirack Mini ITX Slide.3mf, mini-itx-shelf.FCStd, mini-itx-spacers-Spacer.3mf, mini-itx-spacers.FCStd, rear-mount-Read Mount.3mf]
2026-07-11 Cad work
    [mini-itx-shelf-Minirack Mini ITX Slide.3mf, mini-itx-shelf.FCStd, rear-mount-Read Mount.3mf, rear-mount-Rear Mount001.3mf, rear-mount.FCStd, router-shelf-Router Shelf.3mf, router-shelf.FCStd, shelves-cura-project.3mf]
2026-07-12 Rack manager work
    [analog-front-end.kicad_sch, mini-itx-shelf.FCStd, rack-manager.kicad_sch, router-shelf.FCStd, router-spacers.FCStd]
2026-07-12 Board manager work
    [rack-manager.kicad_pcb, rack-manager.kicad_sch]
2026-07-12 Rack manager PCB component placement
    [rack-manager.kicad_pcb, rack-manager.kicad_sch]
2026-07-12 Rack monitoring board routing
    [rack-manager.kicad_pcb]
2026-07-13 Rack manager board routing
    [rack-manager.kicad_pcb, rack-manager.kicad_sch]
2026-07-13 Finished routing
    [rack-manager.kicad_pcb]
2026-07-13 More routing
    [RUK0020B.stp, rack-manager.kicad_pcb, rack-manager.kicad_sch]
2026-07-15 Final PCB design, work on 3D cad files
    [bom.csv, components.ods, designators.csv, gusset.FCStd, mini-itx-shelf.FCStd, positions.csv, rack-manager.kicad_pcb, rack-manager.kicad_sch]
2026-07-15 Gussets, antenna holders, finishing touches on plates, misc cad fixes
    [1u-shelf-front-plate.dxf, 1u-shelf.FCStd, 2u-shelf-front-plate.dxf, 2u-shelf.FCStd, SC1_Z97I-PLUS.SLDPRT, SC1_Z97I-PLUS.STEP, antenna-holder.3mf, antenna-holder.FCStd]
2026-07-16 Starting firmware work
    [components.ods, packed-parts.3mf, partitions_4mb.csv]
2026-07-16 Unified firmware loader/app mode
    [partitions_4mb.csv]
2026-07-17 Moved to pure a/b image system
    [partitions_4mb.csv]
2026-07-17 Firmware renaming
    [partitions_4mb.csv]
2026-07-18 Vectors for CNC cutting
    [1u-shelf-front-plate.dxf, 2u-shelf-front-plate.dxf, mini-itx-shelf-bottom-plate-with-ventillation.dxf, mini-itx-shelf-bottom-plate.dxf, mini-itx-shelf-front-plate.dxf, packed-parts.3mf, router-shelf-bottom-plate-with-ventillation.dxf, router-shelf-bottom-plate.dxf]
2026-07-21 Bottom Rack Plate
    [rack-bottom-plate-Body.step, rack-bottom-plate.FCStd]
2026-07-24 Various firmware changes
    [partitions_4mb.csv]
2026-07-24 Basic support for all I2C/SPI peripherals on the rack monitor
2026-07-25 More work on rack-manager firmware
    [RUK0020B.stp, bom.csv, designators.csv, partitions_4mb.csv, positions.csv, rack-manager.csv, rack-manager.kicad_pcb, rack-manager.kicad_sch]
2026-07-26 Rack manager responsibilites and battery-management
2026-09-18 Rack manager improvements, added technical drawings for rack shelves
    [cells.csv, components.ods, mini-itx-shelf.FCStd, rack-bottom-plate.FCStd, router-shelf.FCStd]
2026-10-18 Power rail box CAD model
